remrc/Self-Balancing-Bike/schematic.pdf

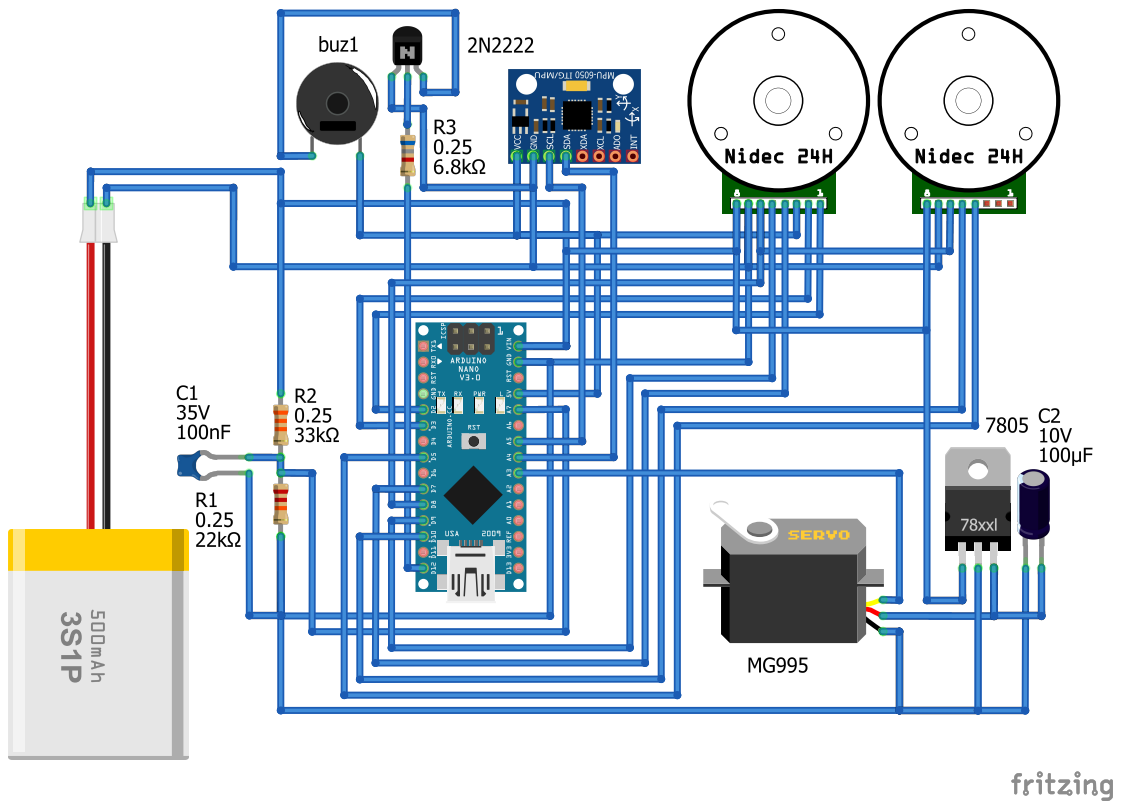
[picture p3: page 1]
